Zhou-yunchuan/QR-Board/hardware/pcb.pdf

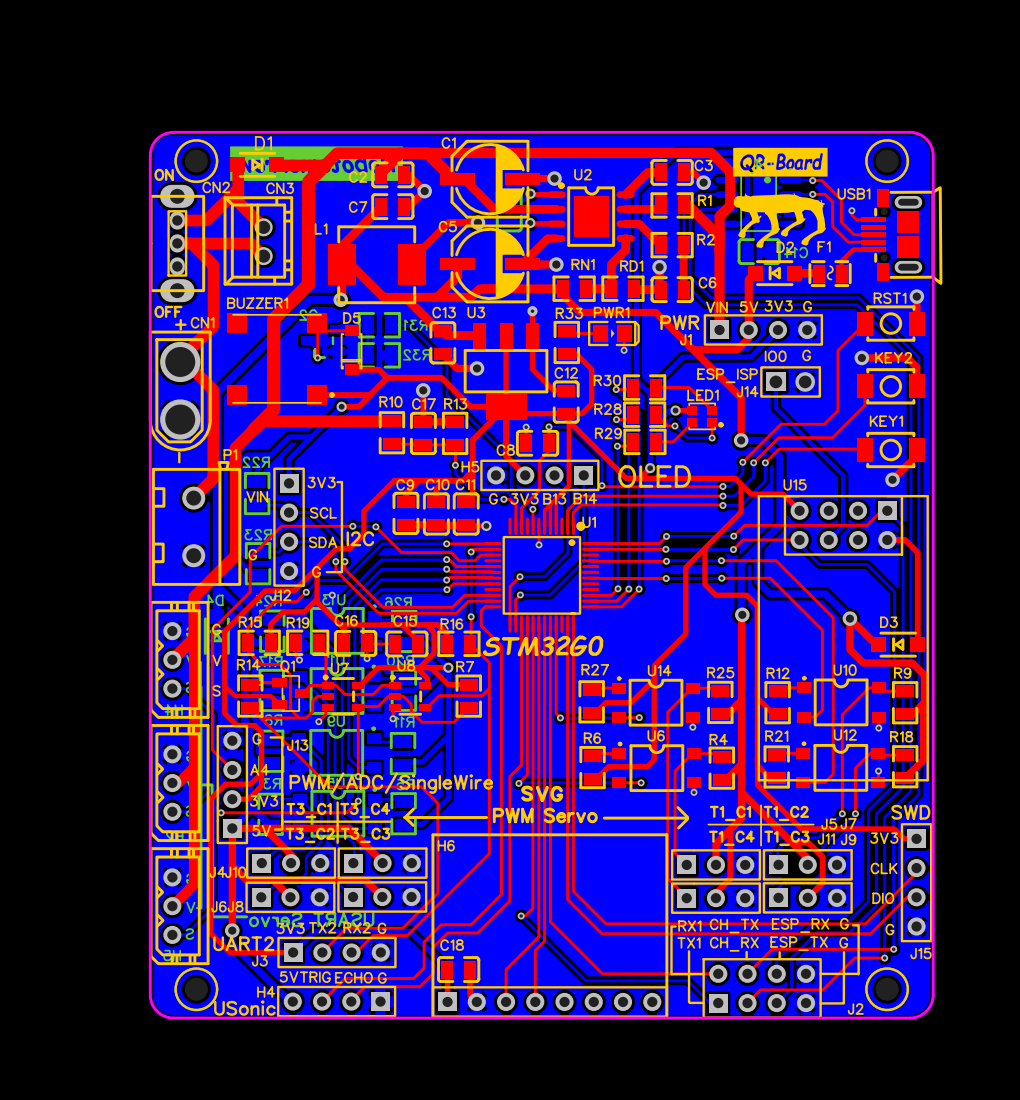
[picture p3: page 1]
