Zhou-yunchuan/QR-Board/hardware/sch.pdf

# 电源接口和开关

# 1 D1防反接二极管经测试作用不大,可去掉

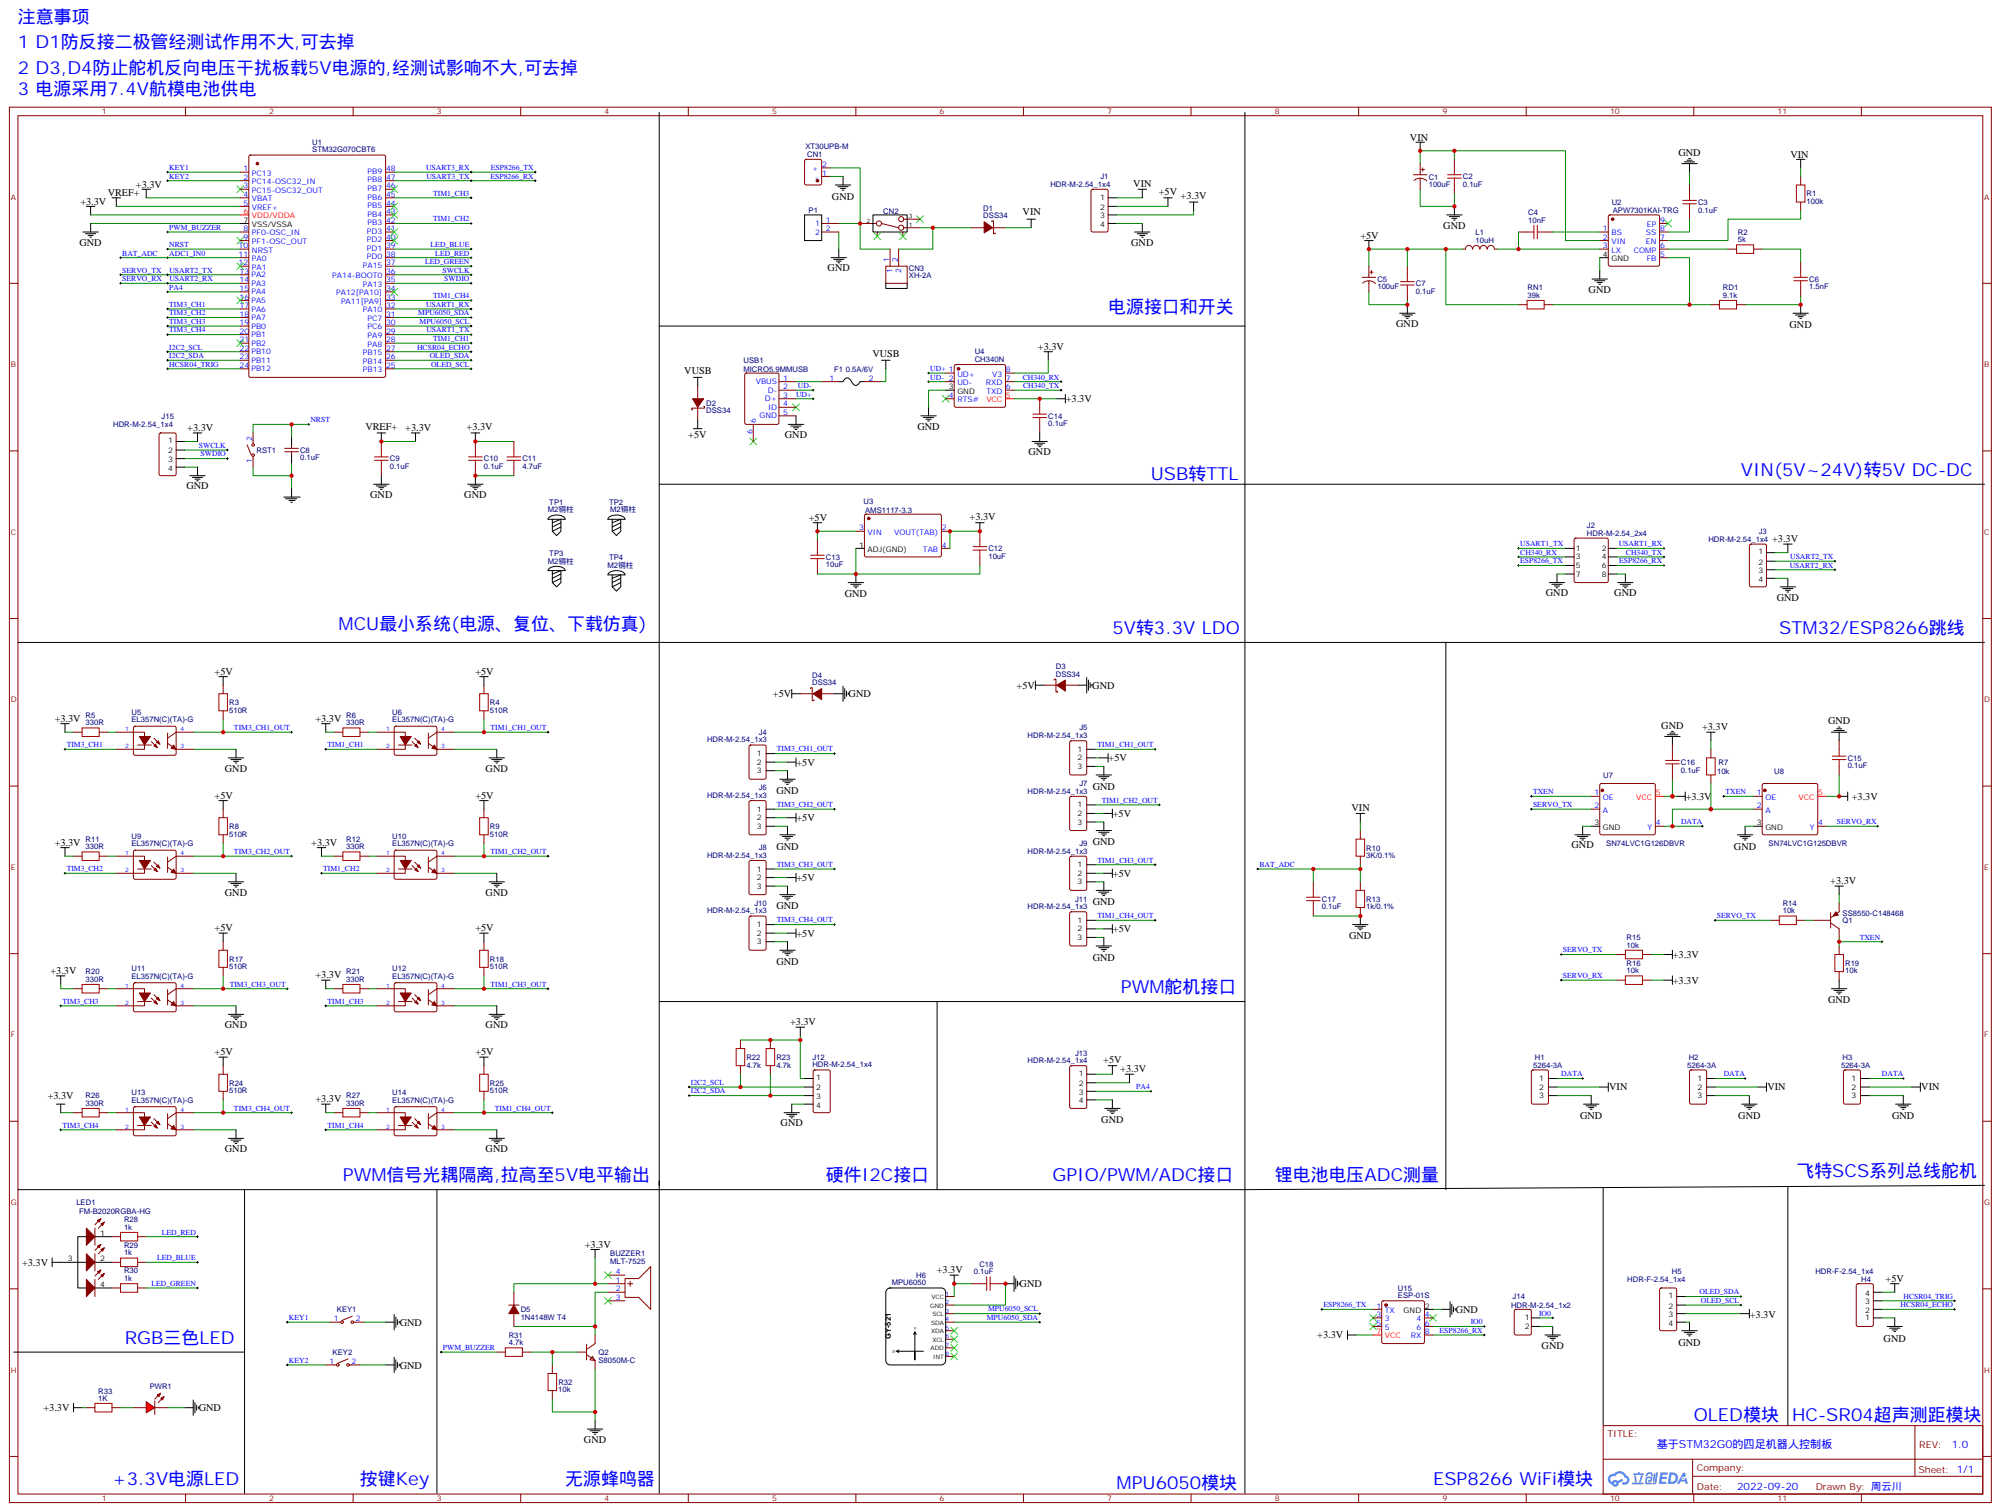
[picture p4: page 1]

MCU最小系统(电源、复位、下载仿真)
