Zhou-yunchuan/QR-Board/bsp_demo/battery/Core/Src/main.c

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
/* Includes ------------------------------------------------------------------*/
#include "main.h"
#include "adc.h"
#include "dma.h"
#include "usart.h"
#include "gpio.h"

/* USER CODE BEGIN Includes */
#include "bsp_led.h"
#include "bsp_time.h"
#include "bsp_battery.h"
#include "bsp_usart.h"

/* USER CODE END Includes */


void SystemClock_Config(void);
/**
  * @brief  The application entry point.
  * @retval int
  */
int main(void)
{
  /* MCU Configuration--------------------------------------------------------*/

  /* Reset of all peripherals, Initializes the Flash interface and the Systick. */
  HAL_Init();

  /* Configure the system clock */
  SystemClock_Config();

  /* Initialize all configured peripherals */
  MX_GPIO_Init();
  MX_DMA_Init();
  MX_USART1_UART_Init();
  MX_ADC1_Init();
  /* USER CODE BEGIN 2 */
    BSP_LED_Init();
    BSP_Time_Init();
    BSP_UART_Init();
    BSP_Battery_Init();
  /* USER CODE END 2 */

  /* Infinite loop */
  /* USER CODE BEGIN WHILE */
  while (1)
  {
    if(BSP_Time_CheckTick() == 1)
    {
        if(BSP_Time_CheckSlice(500) == 1)
        {
            BSP_LED_Toggle(GREEN);
        }
        if(BSP_Time_CheckSlice(500) == 1)
        {
            BSP_Battery_UpdateVoltage();
        }
        if(BSP_Time_CheckSlice(1000) == 1)
        {
            float bat_voltage = BSP_Battery_GetVoltage();
            printf("bat voltage: %.2f",bat_voltage);
        }
    }
    /* USER CODE END WHILE */

    /* USER CODE BEGIN 3 */
  }
  /* USER CODE END 3 */
}

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
