Zhou-yunchuan/QR-Board/bsp_demo/pwmservo/pwmservo.ioc

Mcu.UserName=STM32G070CBTx
PA13.Signal=SYS_SWDIO
PA14-BOOT0.Signal=SYS_SWCLK
PA15.GPIO_Label=LED_GREEN
PA15.Signal=GPIO_Output
PA6.Signal=S_TIM3_CH1
PA7.Signal=S_TIM3_CH2
PA8.Signal=S_TIM1_CH1
PB0.Signal=S_TIM3_CH3
PB1.Signal=S_TIM3_CH4
PB3.Signal=S_TIM1_CH2
PB6.Signal=S_TIM1_CH3
PD0.GPIO_Label=LED_RED
PD0.Signal=GPIO_Output
PD1.GPIO_Label=LED_BLUE
PD1.Signal=GPIO_Output
