Zhou-yunchuan/QR-Board/bsp_demo/hcsr04/Core/Inc/main.h

#define TRIG_Pin GPIO_PIN_12
#define TRIG_GPIO_Port GPIOB
#define ECHO_Pin GPIO_PIN_15
#define ECHO_GPIO_Port GPIOB
#define LED_GREEN_Pin GPIO_PIN_15
#define LED_GREEN_GPIO_Port GPIOA
#define LED_RED_Pin GPIO_PIN_0
#define LED_RED_GPIO_Port GPIOD
#define LED_BLUE_Pin GPIO_PIN_1
#define LED_BLUE_GPIO_Port GPIOD
