Zhou-yunchuan/QR-Board/bsp_demo/mpu6050/BSP/bsp_mpu6050.h

#ifndef BSP_MPU6050_H_
#define BSP_MPU6050_H_

#include "stdint.h"

// #define MPU_ACCEL_OFFS_REG    0X06
// #define MPU_PROD_ID_REG       0X0C
#define MPU_SELF_TESTX_REG      0X0D
#define MPU_SELF_TESTY_REG      0X0E
#define MPU_SELF_TESTZ_REG      0X0F
#define MPU_SELF_TESTA_REG      0X10
#define MPU_SAMPLE_RATE_REG     0X19
#define MPU_CFG_REG             0X1A
#define MPU_GYRO_CFG_REG        0X1B
#define MPU_ACCEL_CFG_REG       0X1C
#define MPU_MOTION_DET_REG      0X1F
#define MPU_FIFO_EN_REG         0X23
#define MPU_I2CMST_CTRL_REG     0X24
#define MPU_I2CSLV0_ADDR_REG    0X25
#define MPU_I2CSLV0_REG         0X26
#define MPU_I2CSLV0_CTRL_REG    0X27
#define MPU_I2CSLV1_ADDR_REG    0X28
#define MPU_I2CSLV1_REG         0X29
#define MPU_I2CSLV1_CTRL_REG    0X2A
#define MPU_I2CSLV2_ADDR_REG    0X2B
#define MPU_I2CSLV2_REG         0X2C
#define MPU_I2CSLV2_CTRL_REG    0X2D
#define MPU_I2CSLV3_ADDR_REG    0X2E
#define MPU_I2CSLV3_REG         0X2F
#define MPU_I2CSLV3_CTRL_REG    0X30
#define MPU_I2CSLV4_ADDR_REG    0X31
#define MPU_I2CSLV4_REG         0X32
#define MPU_I2CSLV4_DO_REG      0X33
#define MPU_I2CSLV4_CTRL_REG    0X34
#define MPU_I2CSLV4_DI_REG      0X35

#define MPU_I2CMST_STA_REG      0X36
#define MPU_INTBP_CFG_REG       0X37
#define MPU_INT_EN_REG          0X38
#define MPU_INT_STA_REG         0X3A

#define MPU_ACCEL_XOUTH_REG     0X3B
#define MPU_ACCEL_XOUTL_REG     0X3C
#define MPU_ACCEL_YOUTH_REG     0X3D
#define MPU_ACCEL_YOUTL_REG     0X3E
#define MPU_ACCEL_ZOUTH_REG     0X3F
#define MPU_ACCEL_ZOUTL_REG     0X40

#define MPU_TEMP_OUTH_REG       0X41
#define MPU_TEMP_OUTL_REG       0X42

#define MPU_GYRO_XOUTH_REG      0X43
#define MPU_GYRO_XOUTL_REG      0X44
#define MPU_GYRO_YOUTH_REG      0X45
#define MPU_GYRO_YOUTL_REG      0X46
#define MPU_GYRO_ZOUTH_REG      0X47
#define MPU_GYRO_ZOUTL_REG      0X48

#define MPU_I2CSLV0_DO_REG      0X63
#define MPU_I2CSLV1_DO_REG      0X64
#define MPU_I2CSLV2_DO_REG      0X65
#define MPU_I2CSLV3_DO_REG      0X66

#define MPU_I2CMST_DELAY_REG    0X67
#define MPU_SIGPATH_RST_REG     0X68
#define MPU_MDETECT_CTRL_REG    0X69
#define MPU_USER_CTRL_REG       0X6A
#define MPU_PWR_MGMT1_REG       0X6B
#define MPU_PWR_MGMT2_REG       0X6C
#define MPU_FIFO_CNTH_REG       0X72
#define MPU_FIFO_CNTL_REG       0X73
#define MPU_FIFO_RW_REG         0X74
#define MPU_DEVICE_ID_REG       0X75

#define MPU_ADDR    0X68


//#define MPU_READ    0XD1
//#define MPU_WRITE   0XD0

typedef struct {
    float roll;
    float pitch;
    float yaw;
    int16_t gx;
    int16_t gy;
    int16_t gz;
    int16_t ax;
    int16_t ay;
    int16_t az;
    int16_t temp;
} MPU6050;

uint8_t BSP_MPU6050_WriteLen(uint8_t addr, uint8_t reg, uint8_t len, uint8_t *buf);
uint8_t BSP_MPU6050_ReadLen(uint8_t addr, uint8_t reg, uint8_t len, uint8_t *buf);
uint8_t BSP_MPU6050_WriteByte(uint8_t reg, uint8_t data);
uint8_t BSP_MPU6050_ReadByte(uint8_t reg);

void BSP_MPU6050_Init(void);
void BSP_MPU6050_UpdateData(void);
MPU6050 *BSP_MPU6050_GetData(void);

#endif
