Zhou-yunchuan/QR-Board/bsp_demo/pwmbuzzer/BSP/bsp_pwmbuzzer.h

#ifndef BSP_PWMBUZZER_H_
#define BSP_PWMBUZZER_H_

void BSP_PWMBuzzer_Init(void);
void BSP_PWMBuzzer_On(void);
void BSP_PWMBuzzer_Off(void);
void BSP_PWMBuzzer_SetFreq(int pwm_freq);
void BSP_PWMBuzzer_Test(void);


#endif  
