Zhou-yunchuan/QR-Board/(notices)

Notices in the files:
bsp_demo/hcsr04/Core/Inc/main.h:
© Copyright (c) 2022 STMicroelectronics.
All rights reserved.
This software component is licensed by ST under Ultimate Liberty license
(C) COPYRIGHT STMicroelectronics *****END OF FILE
